xSnowHeadx/thermo-cam_V3/schematic/thermo-cam.schematic.pdf

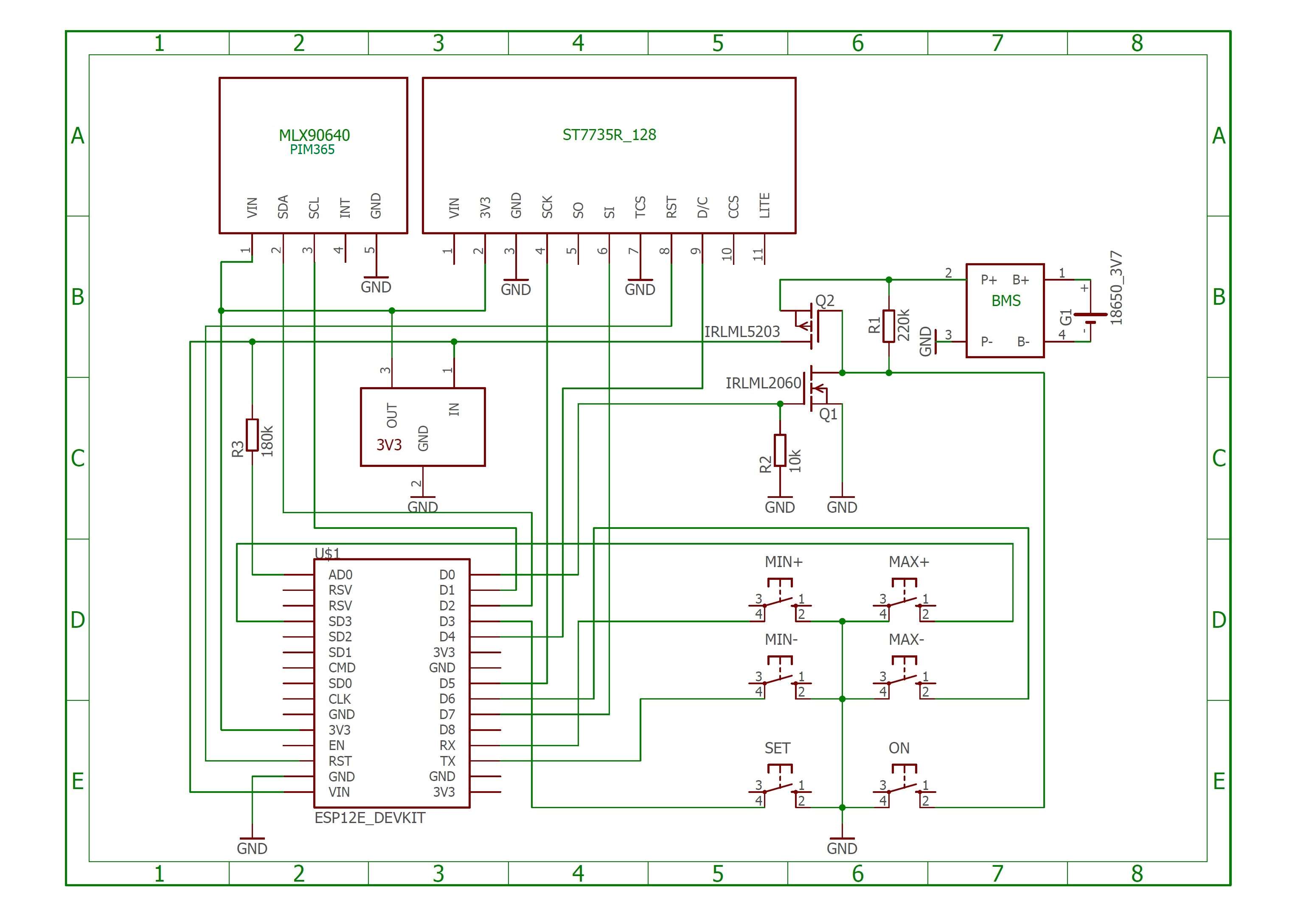
[picture p5: page 1]
