xSnowHeadx/thermo-cam_V3/pictures/tc_back.jpg

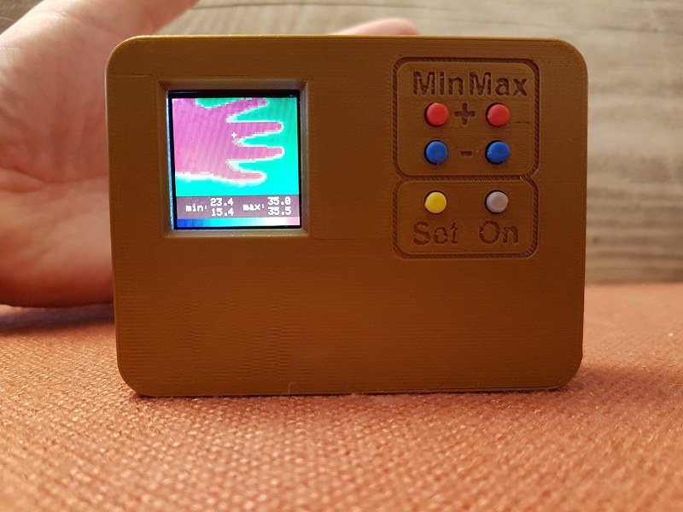
pictures/tc_back.jpg
