xSnowHeadx/thermo-cam_V3/pictures/tc_front.jpg

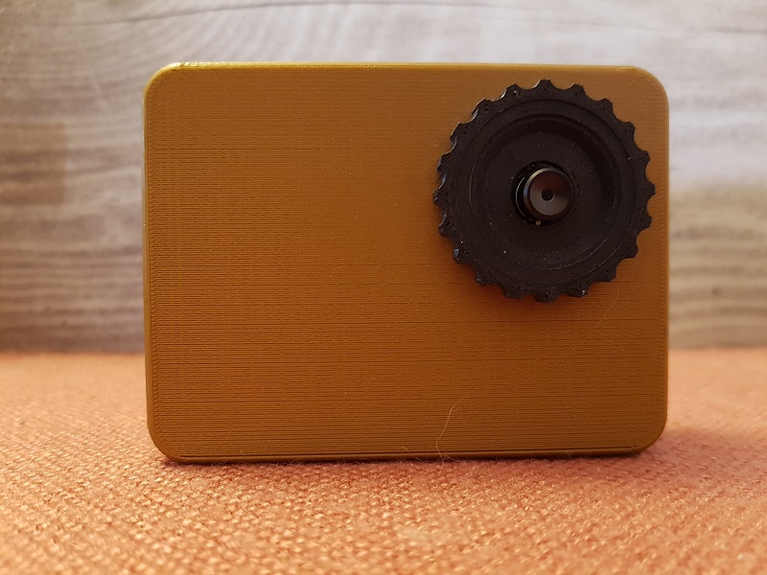
pictures/tc_front.jpg
