xSnowHeadx/thermo-cam_V3/src/thermo-cam_V3.ino

/***************************************************************************
 Firmware for a ThermoCam with MLX90640-Sensor

 Based on an example from Dean Miller, James DeVito & ladyada for Adafruit
 Industries.
 ***************************************************************************/

// ------------------begin ESP8266'centric----------------------------------
#define FREQUENCY     160                  // valid 80, 160

//
#include "ESP8266WiFi.h"
extern "C" {
#include "user_interface.h"
}
// ------------------end ESP8266'centric------------------------------------

#include <Wire.h>
#include <eeprom.h>
#include "OneButton.h"
#include "UrsADC.h"
#include <Adafruit_GFX.h>
#include <TFT_eSPI.h>
#include "MLX90640_API.h"
#include "MLX90640_I2C_Driver.h"

#define COLOR_BAR 1

#define EEPROM_SIZE 128
enum
{
	EEP_VALID, EEP_CALV, EEP_NEXT = EEP_CALV + sizeof(double),
};

// define the button-pins
#define B_MODE  		0
#define B_MAXP 			10
#define B_MAXM 			12
#define B_MINP  		3
#define B_MINM  		1
#define O_PWR  			16

// define position and size of the battery symbol
#define BATT_X 21
#define BATT_Y  9
#define BATT_START_X	100
#define BATT_START_Y	5

// define voltage limit levels
#define VBATT_CRIT		3.5
#define VBATT_EMPT		3.35
#define VBATT_OFF		3.3

// a helper macro
#define min(a,b) ((a)<(b)?(a):(b))

//low range of the sensor (this will be blue on the screen)
int MINTEMP = 15;

//high range of the sensor (this will be red on the screen)
int MAXTEMP = 35;

//@formatter:off
// the yellow battery symbol
static const unsigned short bat_critical[] =
{ 	0xFE41, 0xFE41, 0xFE41, 0xFE41, 0xFE41, 0xFE41, 0xFE41, 0xFE41, 0xFE41, 0xFE41, 0xFE41, 0xFE41, 0xFE41, 0xFE41, 0xFE41, 0xFE41,   // 0x0010 (16) pixels
	0xFE41, 0xFE41, 0xFE41, 0xFFFF, 0xFFFF, 0xFE41, 0xFE41, 0xFE41, 0xFE41, 0xFE41, 0xFE41, 0xFE41, 0xFE41, 0xFE41, 0xFE41, 0xFE41,   // 0x0020 (32) pixels
	0xFE41, 0xFE41, 0xFE41, 0xFE41, 0xFE41, 0xFE41, 0xFE41, 0xFE41, 0xFE41, 0xFFFF, 0xFE41, 0xFE41, 0xFFFF, 0xFFFF, 0xFFFF, 0xFFFF,   // 0x0030 (48) pixels
	0xFFFF, 0xFFFF, 0xFFFF, 0xFFFF, 0xFFFF, 0xFFFF, 0xFFFF, 0xFFFF, 0xFFFF, 0xFFFF, 0xFFFF, 0xFFFF, 0xFE41, 0xFE41, 0xFFFF, 0xFE41,   // 0x0040 (64) pixels
	0xFE41, 0xFFFF, 0xFE41, 0xFE41, 0xFFFF, 0xFFFF, 0xFFFF, 0xFFFF, 0xFFFF, 0xFFFF, 0xFFFF, 0xFFFF, 0xFFFF, 0xFFFF, 0xFFFF, 0xFFFF,   // 0x0050 (80) pixels
	0xFFFF, 0xFE41, 0xFE41, 0xFE41, 0xFE41, 0xFE41, 0xFFFF, 0xFE41, 0xFE41, 0xFFFF, 0xFFFF, 0xFFFF, 0xFFFF, 0xFFFF, 0xFFFF, 0xFFFF,   // 0x0060 (96) pixels
	0xFFFF, 0xFFFF, 0xFFFF, 0xFFFF, 0xFFFF, 0xFFFF, 0xFE41, 0xFE41, 0xFE41, 0xFE41, 0xFE41, 0xFFFF, 0xFE41, 0xFE41, 0xFFFF, 0xFFFF,   // 0x0070 (112) pixels
	0xFFFF, 0xFFFF, 0xFFFF, 0xFFFF, 0xFFFF, 0xFFFF, 0xFFFF, 0xFFFF, 0xFFFF, 0xFFFF, 0xFFFF, 0xFE41, 0xFE41, 0xFE41, 0xFE41, 0xFE41,   // 0x0080 (128) pixels
	0xFFFF, 0xFFFF, 0xFFFF, 0xFFFF, 0xFFFF, 0xFFFF, 0xFFFF, 0xFFFF, 0xFFFF, 0xFFFF, 0xFFFF, 0xFFFF, 0xFFFF, 0xFFFF, 0xFFFF, 0xFFFF,   // 0x0090 (144) pixels
	0xFE41, 0xFE41, 0xFFFF, 0xFE41, 0xFE41, 0xFE41, 0xFE41, 0xFE41, 0xFE41, 0xFE41, 0xFE41, 0xFE41, 0xFE41, 0xFE41, 0xFE41, 0xFE41,   // 0x00A0 (160) pixels
	0xFE41, 0xFE41, 0xFE41, 0xFE41, 0xFE41, 0xFE41, 0xFE41, 0xFFFF, 0xFFFF, 0xFE41, 0xFE41, 0xFE41, 0xFE41, 0xFE41, 0xFE41, 0xFE41,
	0xFE41, 0xFE41, 0xFE41, 0xFE41, 0xFE41, 0xFE41, 0xFE41, 0xFE41, 0xFE41, 0xFE41, 0xFE41, 0xFFFF, 0xFFFF, 0xFFFF
};

// the red battery symbol
static const unsigned short bat_empty[] =
{ 	0xE8E4, 0xE8E4, 0xE8E4, 0xE8E4, 0xE8E4, 0xE8E4, 0xE8E4, 0xE8E4, 0xE8E4, 0xE8E4, 0xE8E4, 0xE8E4, 0xE8E4, 0xE8E4, 0xE8E4, 0xE8E4,   // 0x0010 (16) pixels
	0xE8E4, 0xE8E4, 0xE8E4, 0xFFFF, 0xFFFF, 0xE8E4, 0xE8E4, 0xE8E4, 0xE8E4, 0xE8E4, 0xE8E4, 0xE8E4, 0xE8E4, 0xE8E4, 0xE8E4, 0xE8E4,   // 0x0020 (32) pixels
	0xE8E4, 0xE8E4, 0xE8E4, 0xE8E4, 0xE8E4, 0xE8E4, 0xE8E4, 0xE8E4, 0xE8E4, 0xFFFF, 0xE8E4, 0xE8E4, 0xFFFF, 0xFFFF, 0xFFFF, 0xFFFF,   // 0x0030 (48) pixels
	0xFFFF, 0xFFFF, 0xFFFF, 0xFFFF, 0xFFFF, 0xFFFF, 0xFFFF, 0xFFFF, 0xFFFF, 0xFFFF, 0xFFFF, 0xFFFF, 0xE8E4, 0xE8E4, 0xFFFF, 0xE8E4,   // 0x0040 (64) pixels
	0xE8E4, 0xFFFF, 0xFFFF, 0xFFFF, 0xFFFF, 0xFFFF, 0xFFFF, 0xFFFF, 0xFFFF, 0xFFFF, 0xFFFF, 0xFFFF, 0xFFFF, 0xFFFF, 0xFFFF, 0xFFFF,   // 0x0050 (80) pixels
	0xFFFF, 0xE8E4, 0xE8E4, 0xE8E4, 0xE8E4, 0xE8E4, 0xFFFF, 0xFFFF, 0xFFFF, 0xFFFF, 0xFFFF, 0xFFFF, 0xFFFF, 0xFFFF, 0xFFFF, 0xFFFF,   // 0x0060 (96) pixels
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
#define INTERPOLATED_ROWS 	48			// 96 temperature points per row on TFT
#define RAWMODE				0x02		// bitmask for not interpolated display
#define MANUAL				0x01		// bitmask for manual temperature ranges
#define TA_SHIFT 8 //Default shift for MLX90640 in open air

bool blink_flag = false;		// common flag for blink functions
bool volt_flag = false;		// voltage display mode active
bool cal_flag = false;		// calibration mode active
double cal_val, cal_step;				// help values for calibration mode
int cal_pos;
double VBATT_CORR = 0.0051939453125;	// scaling factor for voltage measurement
double min_drag = 999.0;		// lower value of trailing pointers
double max_drag = -999.0;		// higher value of trailing pointers
uint32_t blink_millis = 0;			// timer for blink functions
uint32_t auto_off_millis;				// timer for automatic shutdown
const byte MLX90640_address = 0x33; //Default 7-bit unshifted address of the MLX90640
//uint16_t dest_2d[SENS_ROWS * SENS_COLS];
paramsMLX90640 mlx90640;
const byte calcStart = 33; //Pin that goes high/low when calculations are complete
//This makes the timing visible on the logic analyzer
volatile int modeflag = 0;
volatile int draginit = 1;
uint16_t mlx90640Frame[834];
float pixels[SENS_ROWS * SENS_COLS];
short dest_2d[INTERPOLATED_ROWS * INTERPOLATED_COLS];

TFT_eSPI tft = TFT_eSPI();       		// Invoke custom library
OneButton b_mode(B_MODE, true);			// create button objects
OneButton b_maxp(B_MAXP, true);
OneButton b_maxm(B_MAXM, true);
OneButton b_minp(B_MINP, true);
OneButton b_minm(B_MINM, true);

// interpolate the 8x8 sensor array to 128x96 for TFT
void interpolate_image(float *src, uint8_t src_rows, uint8_t src_cols, short *dest, uint8_t dest_rows, uint8_t dest_cols);

// calculate the coordinates of given point index
short get_spoint(short *p, uint8_t rows, uint8_t cols, int8_t x, int8_t y)
{
	if (x < 0)
		x = 0;
	if (y < 0)
		y = 0;
	if (x >= cols)
		x = cols - 1;
	if (y >= rows)
		y = rows - 1;
	return p[y * cols + x];
}

// draw the pixels regarding the measured temperatures
void drawpixels(float *p, uint8_t rows, uint8_t cols, uint8_t boxWidth, uint8_t boxHeight);

// read a double value from given address in EEPROM
double eep_read_double(int address)
{
	unsigned int i;
	double dval;
	unsigned char *cp = (unsigned char*) &dval;

	for (i = 0; i < sizeof(double); i++)
	{
		*cp = EEPROM.read(address + i);
		++cp;
	}
	return dval;
}

// write a double value to given address in EEPROM
void eep_write_double(int address, double value)
{
	unsigned int i;
	double dval = value;
	unsigned char *cp = (unsigned char*) &dval;

	for (i = 0; i < sizeof(double); i++)
	{
		EEPROM.write(address + i, *cp);
		++cp;
	}
	EEPROM.commit();
}

// measure the battery voltage
double read_batt(void)
{
	return ((double) UrsAdc.read() * VBATT_CORR);
}

// doubleclick function of MIN-
void toggle_cal_flag(void)
{
	if (cal_flag ^= 1)
	{
		volt_flag = 0;
		cal_val = read_batt();
		cal_step = 1.0;
		cal_pos = 0;
		tft.setTextSize(2);
		tft.fillScreen(TFT_BLACK);
		tft.setCursor(12, tft.height() / 2 - 49);
		tft.print("measured");
		tft.setCursor(12, tft.height() / 2 - 32);
		tft.print("Voltage:");
	}
}

// doubleclick function of MIN+
void toggle_volt_flag(void)
{
	if (!cal_flag)
	{
		if (volt_flag ^= 1)
		{
			tft.setTextSize(2);
			tft.setCursor(12, tft.height() / 2 - 32);
			tft.fillScreen(TFT_BLACK);
			tft.print("Voltage:");
		}
		auto_off_millis = millis();
	}
}

// click function of SET
void init_dragging(void)
{
	draginit = 1;
	auto_off_millis = millis();
}

// longpress function of SET
void next_mode(void)
{
	if (cal_flag)
	{
		VBATT_CORR = cal_val / (double) UrsAdc.read();
		eep_write_double(EEP_CALV, VBATT_CORR);
		cal_flag = 0;
	}
	else
	{
		++modeflag;
		modeflag %= 3;
		if (modeflag & MANUAL)
		{
			max_drag = (int) max_drag;
			min_drag = (int) min_drag;
		}
	}
	auto_off_millis = millis();
}

// click function of MAX+
void do_maxp(void)
{
	if (cal_flag)
	{
		if ((cal_val + cal_step) <= 5.5)
			cal_val += cal_step;
		blink_millis = 0;
	}
	else
	{
		if (modeflag & MANUAL)
			++max_drag;
	}
	auto_off_millis = millis();
}

// click function of MAX-
void do_maxm(void)
{
	if (cal_flag)
	{
		if ((cal_val - cal_step) >= 3.0)
			cal_val -= cal_step;
		blink_millis = 0;
	}
	else
	{
		if (modeflag & MANUAL)
			if ((max_drag - min_drag) > 6)
				--max_drag;
	}
	auto_off_millis = millis();
}

// click function of MIN+
void do_minp(void)
{
	if (cal_flag)
	{
		if (cal_pos < 3)
		{
			cal_pos++;
			cal_step /= 10.0;
		}
		blink_millis = 0;
	}
	else
	{
		if (modeflag & MANUAL)
			if ((max_drag - min_drag) > 6)
				++min_drag;
	}
	auto_off_millis = millis();
}

// click function of MIN-
void do_minm(void)
{
	if (cal_flag)
	{
		if (cal_pos > 0)
		{
			cal_pos--;
			cal_step *= 10.0;
		}
		blink_millis = 0;
	}
	else
	{
		if (modeflag & MANUAL)
			--min_drag;
	}
	auto_off_millis = millis();
}

// doubleclick function of SET and common shutdown
void power_off(void)
{
	digitalWrite(O_PWR, LOW);
}

// show the battery symbol if necessary
void show_batt(void)
{
	int i, j;
	unsigned short *bptr;
	uint32_t last_millis = millis();
	static double voltage;

	voltage = read_batt();
	if ((last_millis - blink_millis) > 1000)
	{
		blink_flag ^= 1;
		blink_millis = last_millis;
	}
	if (voltage < VBATT_CRIT)
	{
		bptr = (unsigned short*) bat_critical;
		if (voltage < VBATT_EMPT)
			bptr = (unsigned short*) bat_empty;
		if (voltage < VBATT_OFF)
			power_off();
		if (blink_flag)
		{
			for (j = 0; j < BATT_Y; j++)
			{
				for (i = 0; i < BATT_X; i++)
				{
					if (*bptr != TFT_WHITE)
						tft.drawPixel(BATT_START_X + i, BATT_START_Y + j, (unsigned short) *bptr);
					++bptr;
				}
			}
		}
	}
}

//Returns true if the MLX90640 is detected on the I2C bus
boolean isConnected()
{
	Wire.beginTransmission((uint8_t) MLX90640_address);
	if (Wire.endTransmission() != 0)
		return (false); //Sensor did not ACK
	return (true);
}

void setup()
{
	WiFi.forceSleepBegin();                  // turn off ESP8266 RF
	delay(1);                                // give RF section time to shutdown
	system_update_cpu_freq(FREQUENCY);

	pinMode(O_PWR, OUTPUT);
	digitalWrite(O_PWR, HIGH);				// hold the power switch

	Serial.begin(115200);
	Serial.println("\n\nAMG88xx Interpolated Thermal Camera!");

	EEPROM.begin(EEPROM_SIZE);
	if (EEPROM.read(EEP_VALID) == 0xAA)
	{
		VBATT_CORR = eep_read_double(EEP_CALV);
	}
	else
	{
		EEPROM.write(EEP_VALID, 0xAA);
		eep_write_double(EEP_CALV, VBATT_CORR);
	}

	// attach the button functions
	b_mode.attachClick(init_dragging);
	b_mode.attachLongPressStart(next_mode);
	b_mode.attachDoubleClick(power_off);
	b_maxp.attachClick(do_maxp);
	b_maxp.attachDuringLongPress(do_maxp);
	b_maxm.attachClick(do_maxm);
	b_maxm.attachDuringLongPress(do_maxm);
	b_minp.attachClick(do_minp);
	b_minp.attachDuringLongPress(do_minp);
	b_minp.attachDoubleClick(toggle_volt_flag);
	b_minm.attachClick(do_minm);
	b_minm.attachDuringLongPress(do_minm);
	b_minm.attachDoubleClick(toggle_cal_flag);

	// init the TFT
	tft.begin();
	tft.setRotation(2);
	tft.fillScreen(TFT_BLACK);
	for(int i = 0; i < 128; i++)
	{
		tft.drawFastVLine(i, 119, 8, camColors[2 * i + 1]);
	}

	auto_off_millis = millis();

	Wire.begin();
	Wire.setClock(400000); //Increase I2C clock speed to 400kHz

	if (isConnected() == false)
	{
		Serial.println("MLX90640 not detected at default I2C address. Please check wiring. Freezing.");
		while (1)
			;
	}

	//Get device parameters - We only have to do this once
	int status;

	status = MLX90640_DumpEE(MLX90640_address, mlx90640Frame);
	if (status != 0)
		Serial.println("Failed to load system parameters");

	status = MLX90640_ExtractParameters(mlx90640Frame, &mlx90640);
	if (status != 0)
		Serial.println("Parameter extraction failed");
	MLX90640_SetRefreshRate(MLX90640_address, 0x04); //Set rate to 4Hz effective - Works
//	MLX90640_SetInterleavedMode(MLX90640_address);
		//Once EEPROM has been read at 400kHz we can increase to 1MHz
	Wire.setClock(1000000);

	Serial.end();		// no further serial output

	// reconfigure the button pins (serial output is disabled now)
	pinMode(B_MAXM, INPUT_PULLUP);
	pinMode(B_MAXP, INPUT_PULLUP);
	pinMode(B_MINM, INPUT_PULLUP);
	pinMode(B_MINP, INPUT_PULLUP);
	pinMode(B_MODE, INPUT_PULLUP);
//	wdt_reset();
}

void loop()
{
	volatile unsigned long amill;
	char txt[64];
	int status;

	for (byte x = 0; x < 2; x++)
	{
		uint16_t mlx90640Frame[834];
		status = MLX90640_GetFrameData(MLX90640_address, mlx90640Frame);

		float vdd = MLX90640_GetVdd(mlx90640Frame, &mlx90640);
		float Ta = MLX90640_GetTa(mlx90640Frame, &mlx90640);

		float tr = Ta - TA_SHIFT; //Reflected temperature based on the sensor ambient temperature
		float emissivity = 0.95;

		MLX90640_CalculateTo(mlx90640Frame, &mlx90640, emissivity, tr, pixels);
	}
	// do the button functions
	b_mode.tick();
	b_maxp.tick();
	b_maxm.tick();
	b_minp.tick();
	b_minm.tick();

	amill = millis();

	if (cal_flag)								// calibration mode?
	{
		if ((amill - blink_millis) > 500)
		{
			dtostrf(cal_val, 5, 3, txt);		// print calibration value
			if (blink_flag)
			{
				txt[cal_pos + ((cal_pos) ? 1 : 0)] = ' ';	// let active position blink
			}
			tft.setCursor(30, tft.height() / 2 - 5);
			tft.fillRect(30, tft.height() / 2 - 5, 60, 20, TFT_BLACK);
			tft.print(txt);						// write text to TFT
			blink_millis = amill;
			blink_flag ^= 1;
		}
	}
	else if (volt_flag)							// voltage display mode?
	{
		if ((amill - blink_millis) > 500)
		{
			tft.setCursor(30, tft.height() / 2 - 5);
			dtostrf(read_batt(), 4, 2, txt);	// print voltage value
			strcat(txt, " V");
			tft.fillRect(30, tft.height() / 2 - 5, 46, 20, TFT_BLACK);
			tft.print(txt);						// write text to TFT
			blink_millis = amill;
			blink_flag ^= 1;
		}
	}
	else										// normal display mode
	{
		if (!status)
		{
			pixels[SENS_ROWS * SENS_COLS - (SENS_COLS - 3)] = (pixels[SENS_ROWS * SENS_COLS - (SENS_COLS - 4)] + pixels[SENS_ROWS * SENS_COLS - (SENS_COLS - 2)]) / 2.0;
			if (modeflag & RAWMODE)					// interpolation disabled?
			{
				unsigned char boxsize = min(tft.width() / SENS_COLS, tft.height() / SENS_ROWS);
				short dest_2d[SENS_ROWS * SENS_COLS];

				for (int i = 0; i < SENS_ROWS * SENS_COLS; i++)
					dest_2d[i] = (short) (pixels[i] * 100.0 + 0.5);
				// draw pixels not interpolated
				drawpixels(dest_2d, SENS_ROWS, SENS_COLS, boxsize, boxsize);
			}
			else									// interpolation enabled?
			{
				unsigned char boxsize = min(tft.width() / INTERPOLATED_COLS, tft.height() / INTERPOLATED_ROWS);
				interpolate_image(pixels, SENS_ROWS, SENS_COLS, dest_2d, INTERPOLATED_ROWS, INTERPOLATED_COLS);
				// draw pixels not interpolated
				drawpixels(dest_2d, INTERPOLATED_ROWS, INTERPOLATED_COLS, boxsize, boxsize);
			}
		}
	}
	// test for necessary auto shutdown
	if ((amill - auto_off_millis) > AUTO_OFF_TIMEOUT)
		if (read_batt() < 4.1)
			power_off();

//	wdt_reset();
}

void drawpixels(short *p, uint8_t rows, uint8_t cols, uint8_t boxWidth, uint8_t boxHeight)
{
	int colorTemp;
	uint8_t colorIndex;
	unsigned long lmill = 0;
	float tmin = 100.0, tmax = 0;
	char txt[64];
	unsigned char xmax = 0, ymax = 0, tpos;
	bool nobox = (boxWidth == 1) && (boxHeight == 1);
	static bool firstloop = true;

	// for all pixels
	for (int y = 0; y < rows; y++)
	{
		for (int x = 0; x < cols; x++)
		{
			// find minimal and maximal values
			float val = ((float) get_spoint(p, rows, cols, x, y)) / 100.0;
			if (val >= MAXTEMP)
				colorTemp = MAXTEMP;
			else if (val <= MINTEMP)
				colorTemp = MINTEMP;
			else
				colorTemp = val;
			if (val > tmax)
			{
				tmax = val;
				xmax = x;
				ymax = y;
			}
			if ((val < tmin) && (val > 1.0) && !firstloop)
				tmin = val;

			if (draginit)
			{
				draginit = 0;
				if (modeflag & MANUAL)
				{
					max_drag = (int) max_drag;
					min_drag = (int) min_drag;
				}
				else
				{
					min_drag = tmin;
					max_drag = tmax;
				}
			}
			else
			{
				if (!(modeflag & MANUAL))
				{
					if ((tmin > 0.0) && (tmin < min_drag))
						min_drag = tmin;
					if (tmax > max_drag)
						max_drag = tmax;
				}
			}
			// map temperature to color
			colorIndex = map(colorTemp, MINTEMP, MAXTEMP, 0, 255);
			colorIndex = constrain(colorIndex, 0, 255);
			// draw the colored rectangle
			if (nobox)
				tft.drawPixel(boxWidth * (cols - x - 1), boxHeight * y, camColors[colorIndex]);
			else
				tft.fillRect(boxWidth * (cols - x - 1), boxHeight * y, boxWidth, boxHeight, camColors[colorIndex]);
		}
		// show battery symbol if necessary
		show_batt();
	}
	firstloop = false;
	// refresh text every 750ms
	if ((millis() - lmill) > 750)
	{
		lmill = millis();
#if COLOR_BAR
		tpos = 99;
		tft.fillRect(0, 96, 128, 23, TFT_BROWN);
#else
		tpos = 104;
		tft.fillRect(0, 104, 128, 31, TFT_BROWN);
#endif
		tft.setTextSize(1);
		tft.setTextColor(TFT_WHITE);
		strcpy(txt, "min:      max:");
		tft.setCursor(10, tpos + 5);
		tft.print(txt);
		dtostrf(tmin, 4, 1, txt);
		tft.setCursor(36, tpos);
		tft.print(txt);
		dtostrf(tmax, 4, 1, txt);
		tft.setCursor(96, tpos);
		tft.print(txt);
		if (modeflag & MANUAL)
			tft.setTextColor(TFT_LIGHTGREY);
		tpos += 10;
		dtostrf(min_drag, 4, 1, txt);
		tft.setCursor(36, tpos);
		tft.print(txt);
		dtostrf(max_drag, 4, 1, txt);
		tft.setCursor(96, tpos);
		tft.print(txt);
		tpos = boxWidth * xmax + (boxWidth >> 1);
		if (tpos > tft.width() - 2 * boxWidth)
			tpos = tft.width() - 2 * boxWidth;
		tft.setCursor(127 - tpos, boxHeight * ymax + (boxHeight >> 1) - 2);
		tft.print("+");
		MINTEMP = min_drag;
		MAXTEMP = max_drag;
		if ((MAXTEMP - MINTEMP) < 5)
		{
			MAXTEMP = MINTEMP + 5;
		}
	}
}
